petmar0/DepthTesting/map.jpg

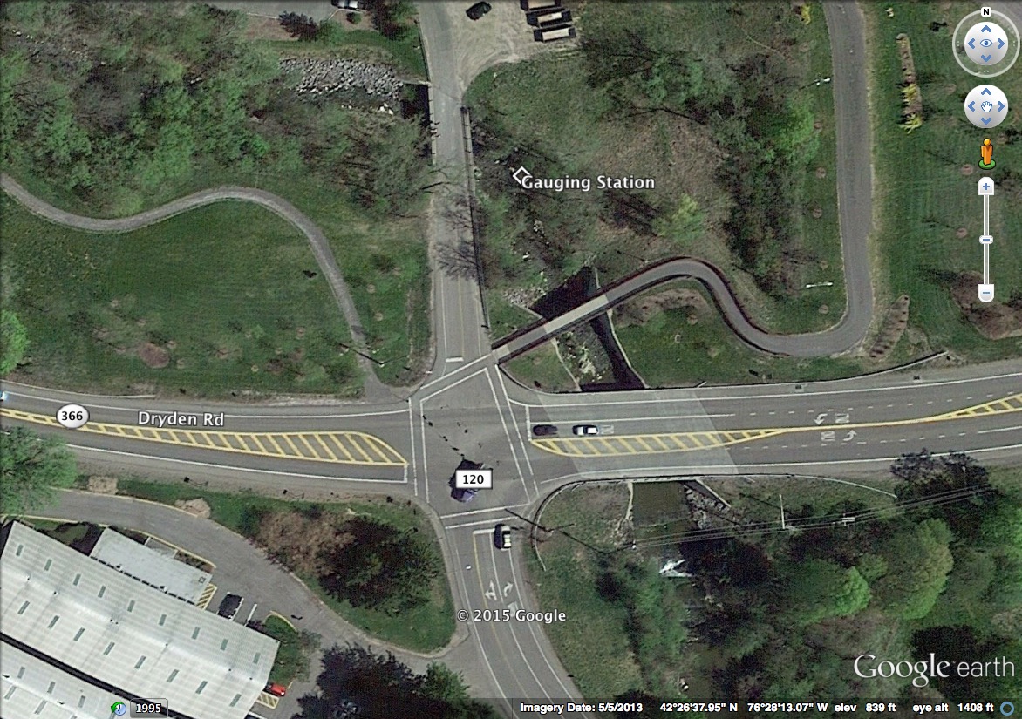
map.jpg
