petmar0/DepthTesting/logs.png

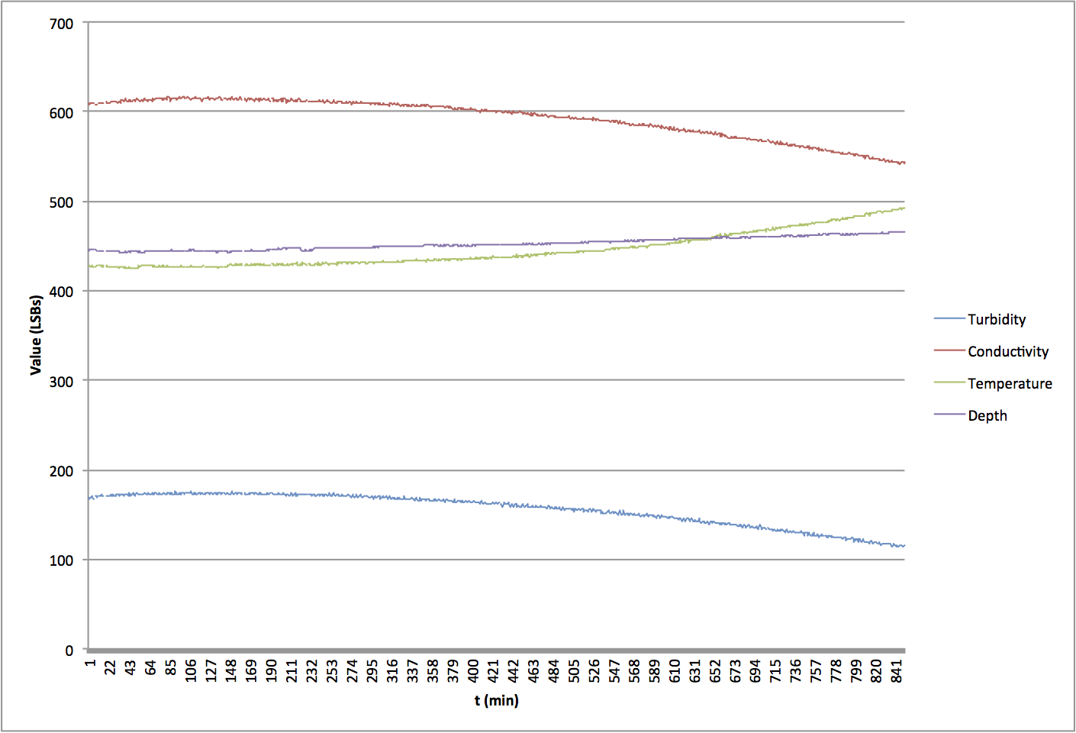
logs.png
